mlstarcher305/trays/stl/magnets/lid.stl

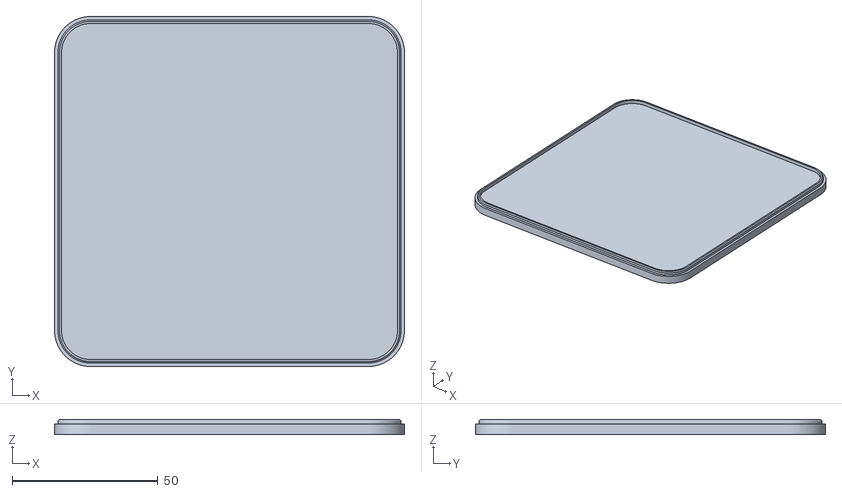
[picture p6: CAD file, 2026-10-26]
stl/magnets/lid.stl
120.0 x 120.0 x 5.20
