mlstarcher305/trays/stl/tall.stl

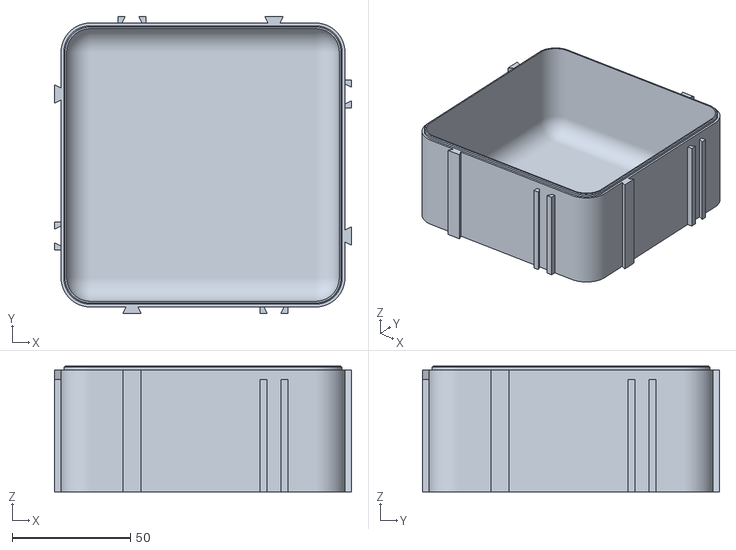
[picture p7: CAD file, 2026-10-26]
stl/tall.stl
125.5 x 125.5 x 53.2
