mlstarcher305/trays/stl/lid.stl

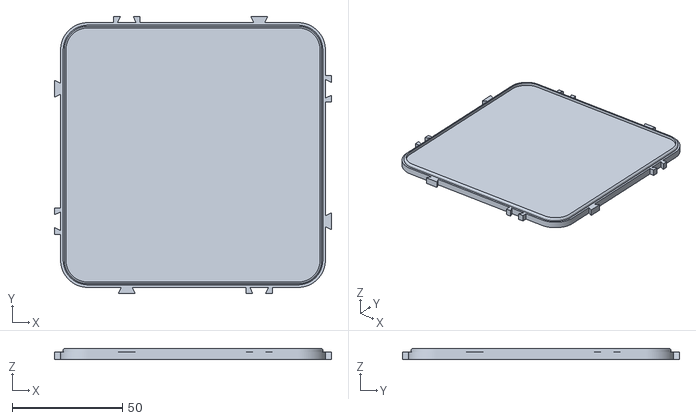
[picture p8: CAD file, 2026-10-26]
stl/lid.stl
125.5 x 125.5 x 5.20
