mlstarcher305/trays/stl/magnets/tall.stl

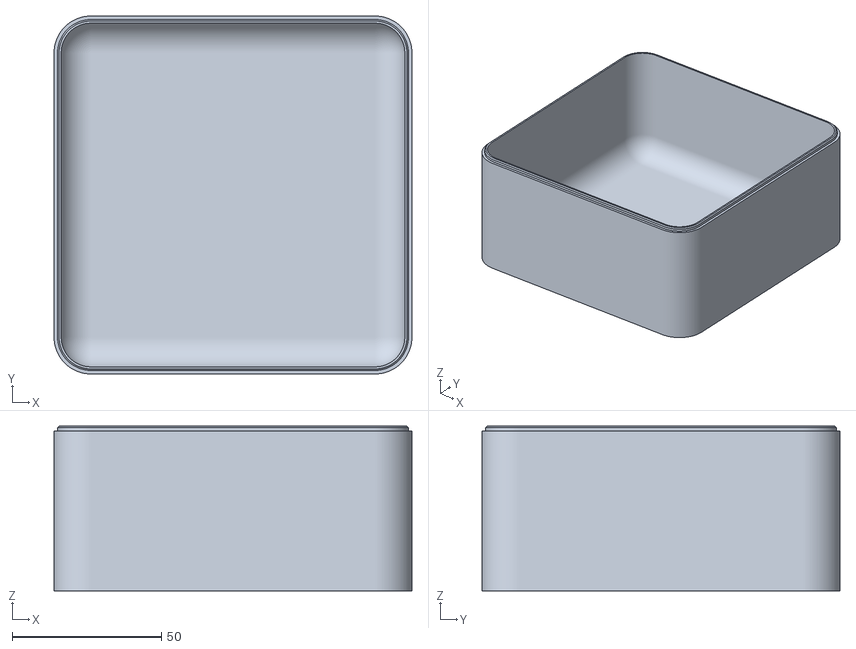
[picture p9: CAD file, 2026-10-26]
stl/magnets/tall.stl
120.0 x 120.0 x 55.2
