mlstarcher305/trays/stl/magnets/six.stl

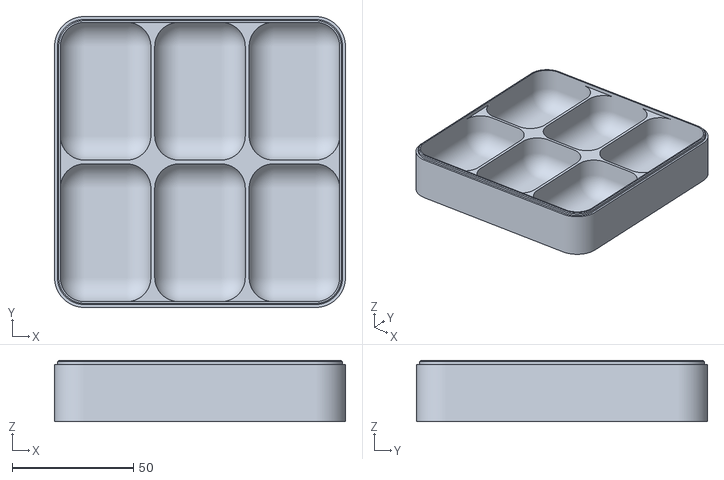
[picture p10: CAD file, 2026-10-26]
stl/magnets/six.stl
120.0 x 120.0 x 25.2
