mlstarcher305/trays/stl/nine.stl

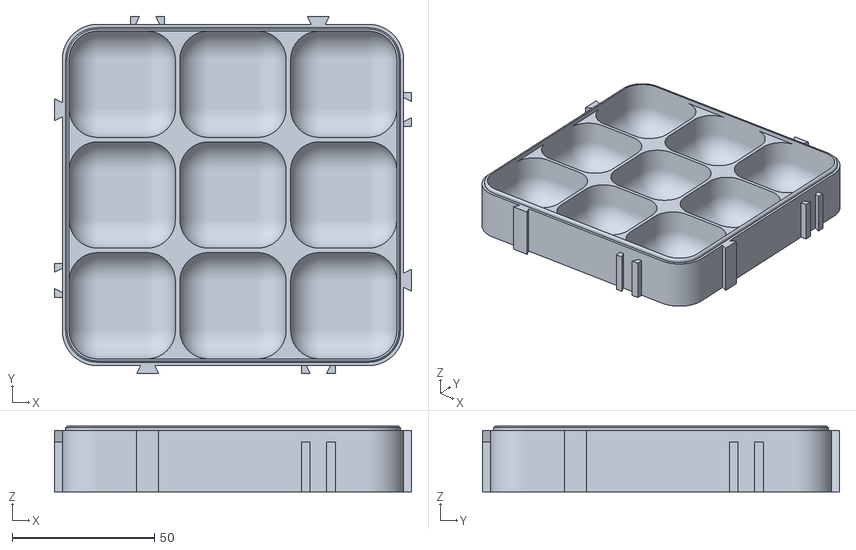
[picture p11: CAD file, 2026-10-26]
stl/nine.stl
125.5 x 125.5 x 23.2
