mlstarcher305/trays/stl/fit-test.stl

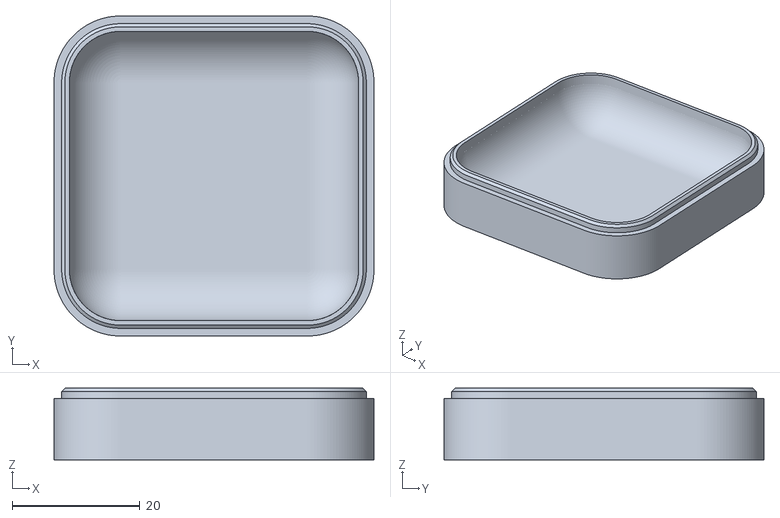
[picture p12: CAD file, 2026-10-26]
stl/fit-test.stl
50.0 x 50.0 x 11.2
