mlstarcher305/trays/stl/magnets/open-deep.stl

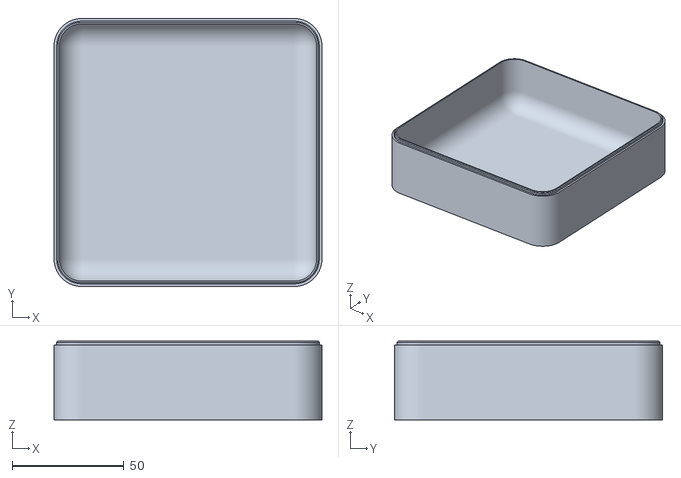
[picture p13: CAD file, 2026-10-26]
stl/magnets/open-deep.stl
120.0 x 120.0 x 35.2
