mlstarcher305/trays/stl/magnets/nine.stl

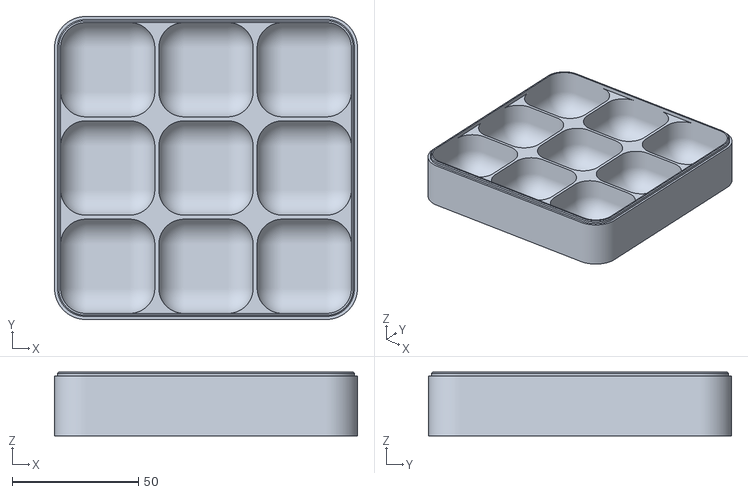
[picture p14: CAD file, 2026-10-26]
stl/magnets/nine.stl
120.0 x 120.0 x 25.2
