mlstarcher305/trays/stl/open-deep.stl

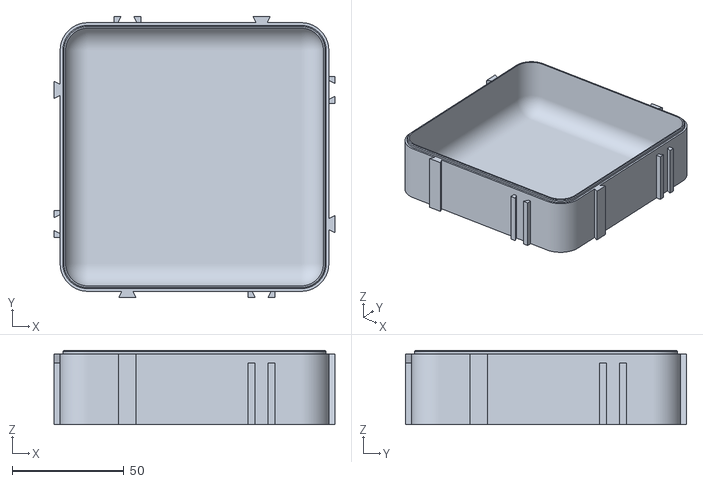
[picture p15: CAD file, 2026-10-26]
stl/open-deep.stl
125.5 x 125.5 x 33.2
