mlstarcher305/trays/stl/magnets/two.stl

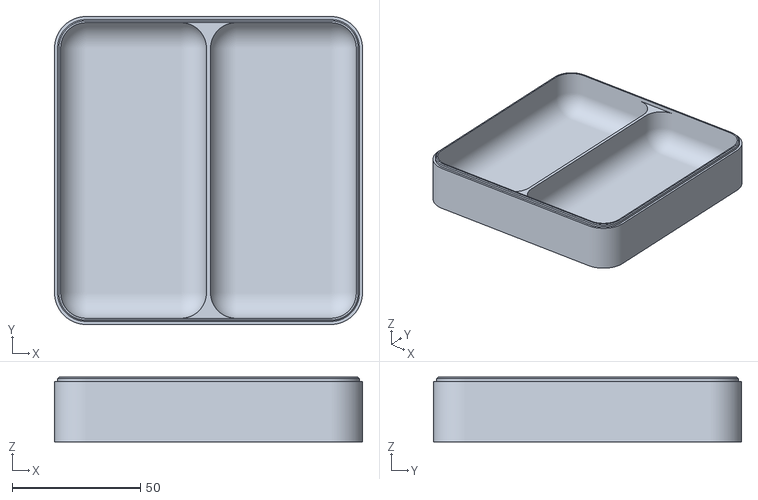
[picture p16: CAD file, 2026-10-26]
stl/magnets/two.stl
120.0 x 120.0 x 25.2
