mlstarcher305/trays/stl/two.stl

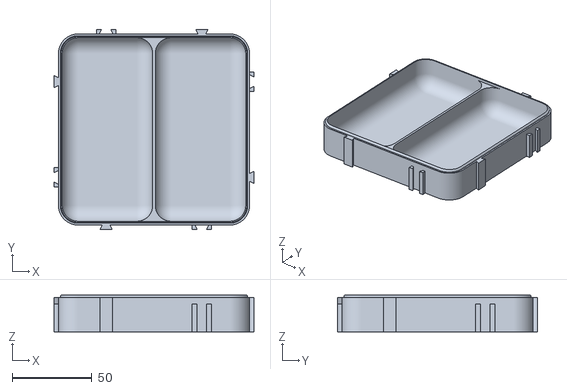
[picture p17: CAD file, 2026-10-26]
stl/two.stl
125.5 x 125.5 x 23.2
