mlstarcher305/trays/stl/magnets/open.stl

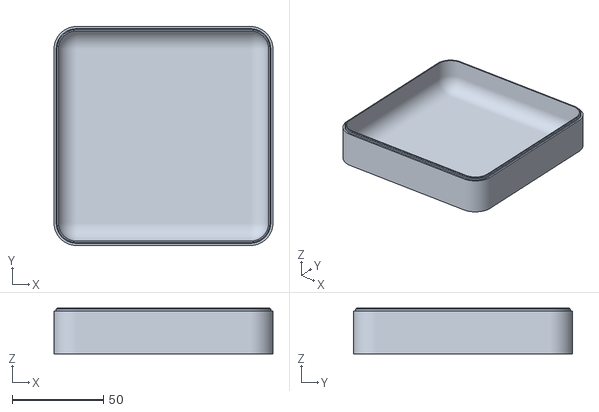
[picture p18: CAD file, 2026-10-26]
stl/magnets/open.stl
120.0 x 120.0 x 25.2
