mlstarcher305/trays/stl/open.stl

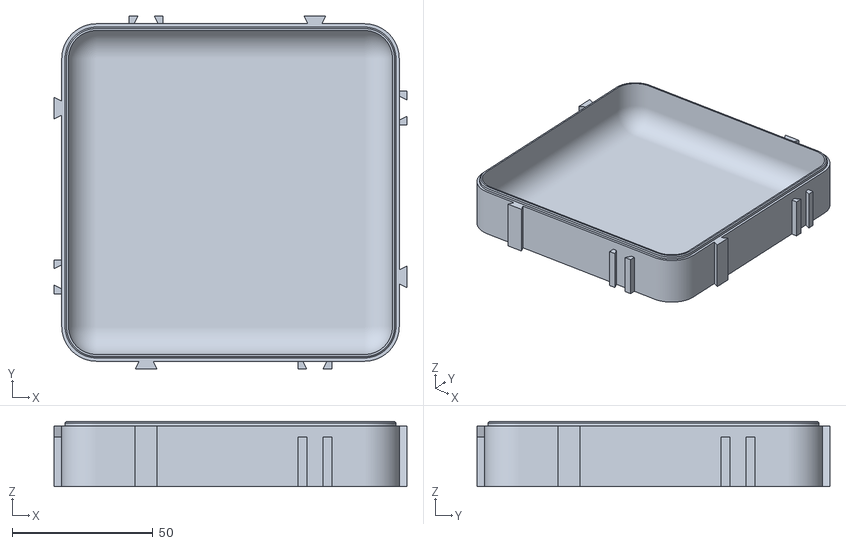
[picture p19: CAD file, 2026-10-26]
stl/open.stl
125.5 x 125.5 x 23.2
