mlstarcher305/trays/stl/magnets/four.stl

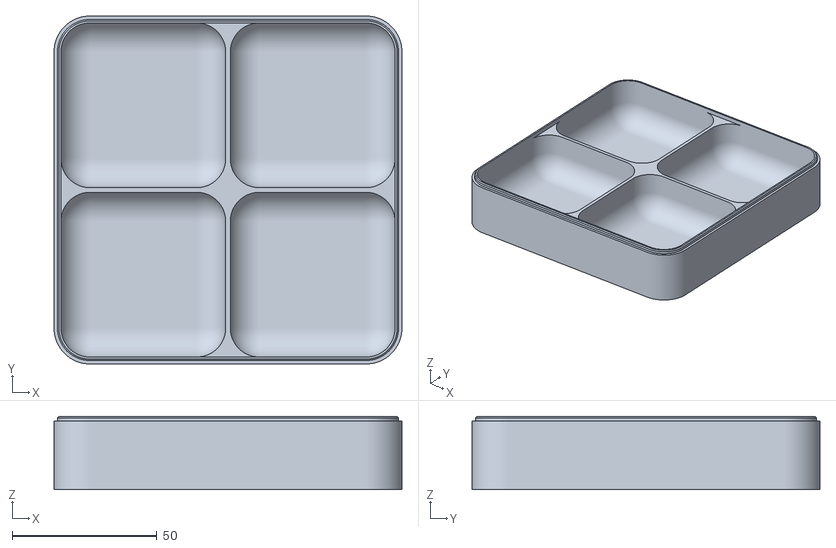
[picture p20: CAD file, 2026-10-26]
stl/magnets/four.stl
120.0 x 120.0 x 25.2
