mlstarcher305/trays/stl/six.stl

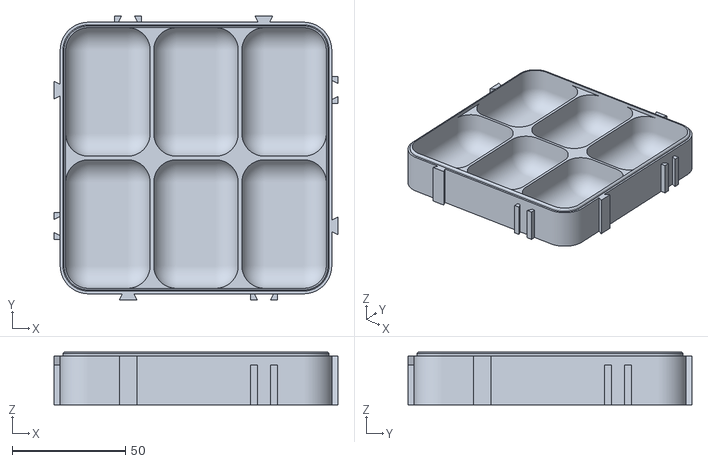
[picture p21: CAD file, 2026-10-26]
stl/six.stl
125.5 x 125.5 x 23.2
