mlstarcher305/trays/stl/four.stl

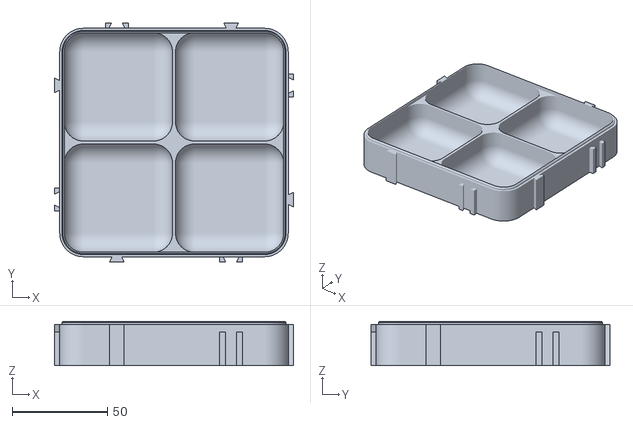
[picture p22: CAD file, 2026-10-26]
stl/four.stl
125.5 x 125.5 x 23.2
