mlstarcher305/trays/(commit log)

2026-10-26 Stacking workshop trays, with tabs, and a magnet version to try
    Shallow 120 mm trays for screws, small electronic parts and small prints,
    modelled in build123d. A tongue and groove keeps stacks from sliding, a
    dovetail tab and slot on every side joins trays side by side, and every inside
    corner is a 10 mm curve so small parts sweep out. The four- and six-compartment
    trays have been printed in PLA on a Bambu Lab X2D.
    The magnet version, untested, buries 6 x 2 mm magnets in the walls and floor
    during two print pauses, in place of the tabs.
    Models, pictures and README under CC BY 4.0; code under MIT.
    [fit-test.stl, four.stl, nine.stl, open-deep.stl, open.stl, six.stl, two.stl]
2026-10-26 A tall tray for motors, and a lid
    The tall tray is the same 120 mm square with the same tongue, groove, tabs and
    slots, but 50 mm deep inside: a NEMA 17 stepper lies on its side with room to
    spare, and the lid still closes. The lid is a flat plate that locks onto any
    tray's rim with the groove underneath, carries the tongue on top so a tray can
    stack on it, and has the tabs and slots so lids on joined trays join too. Its
    slots run its full thickness so a taller tray beside it lowers past.
    The magnet set gets a tall tray and a flush lid. The shared tongue, groove and
    side join moved into helpers; the existing STLs come out byte-identical.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
    [lid.stl, tall.stl]
